ArcticEng/SmokeSense/hardware/DataGuard_Chamber_TSL_v3.stl

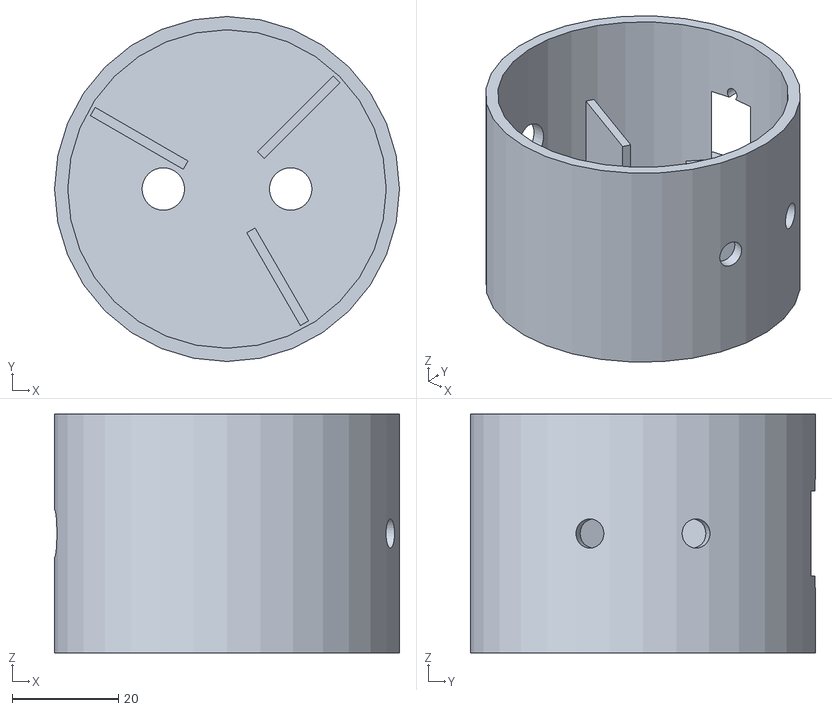
[picture p5: CAD file, 2026-06-24]
hardware/DataGuard_Chamber_TSL_v3.stl
65.0 x 65.0 x 45.0
