ArcticEng/SmokeSense/DataGuard_BringUp_Test_Protocol.docx

DataGuard DG-100

Prototype Bring-up & Test Protocol

Electromechanical commissioning procedure and evidence record

Arctic Engineering · Cape Town

Document owner: ___________________ Version: _______ Date: ____ / ____ / 2026

Records produced by this procedure form part of the R&D evidence base — date, initial and attach evidence at every stage.

# How to use this protocol

Work through the stages in order. A stage is only passed when its expected result is met; if it fails, record what happened and the corrective action, then re-test — failed attempts and iterations are themselves valuable R&D evidence, so do not discard them.

For every numbered check, fill in the Result · date · initials column and capture at least one piece of evidence: a photograph of the bench/wiring, a serial-monitor or dashboard screenshot, or the measured values. Reference each evidence file in the table (e.g. IMG_014).

## Equipment & sources

- Bench power supply: Separate, current-limited rail for the optical LED supply (VLED), isolated from the ESP32 5 V.
- Digital multimeter: Continuity, rail voltages, current draw.
- Laptop + USB: PlatformIO for flashing and serial monitor; ADI Wavetool for the optical chamber (see chamber checklist).
- Smoke sources: Smouldering source (smouldering cotton wick or incense) for large particles; a small controlled flame (tea-light) for fine particles; a reference smoke detector for comparison.
- Air handling: Small fan and a way to clear the chamber/enclosure to clean air between tests; conduct flame tests safely with extinguisher to hand.
- ESD precautions: Wrist strap / grounded mat when handling boards and sensors.

# Stage 0 — Pre-power inspection

# | Check / method | Expected result | Result · date · initials

1 | Visual inspection of all boards and the populated chamber; no solder bridges, correct component orientation (LED anodes, photodiode cathodes). | No defects; components seated in correct bores at the design angles.
2 | Continuity / short test between 3V3, 5V, VLED and GND with power OFF. | No short between any supply rail and ground.
3 | Confirm VLED is on its own rail, not bridged to the ESP32 5 V. | VLED isolated; common ground only.

# Stage 1 — Power & supply rails

# | Check / method | Expected result | Result · date · initials

1 | Apply power; measure 3V3 and 5V rails at the board. | Rails within ±5% of nominal.
2 | Measure VLED rail. | Within the LED operating range (≥ blue LED forward voltage + headroom).
3 | Observe total current draw at idle. | Sane, stable; no thermal runaway or browning-out.

# Stage 2 — MCU, firmware & communications

# | Check / method | Expected result | Result · date · initials

1 | Flash firmware (cd firmware && pio run -t upload). Open serial monitor at 115200. | Clean boot log; no panics or reset loops.
2 | Confirm Wi-Fi association. | Device obtains an IP; RSSI reported.
3 | Confirm MQTT connection to the broker. | Connected; status/heartbeat visible on the broker.

# Stage 3 — I²C bus scan

Confirm every I²C device enumerates before testing sensors individually.

# | Check / method | Expected result | Result · date · initials

1 | Run an I²C scan (serial log or scanner sketch). | ADS1115 at 0x48, BME680 at 0x77 and the ADPD4101 at 0x24 all present.
2 | Check bus stability with all three devices fitted. | Stable; no NAK storms — adjust pull-ups toward ~2.2–4.7 kΩ effective if needed.

# Stage 4 — Individual sensor verification

## 4.1 BME680 — air chemistry & climate

# | Check / method | Expected result | Result · date · initials

1 | Read temperature, humidity, pressure. | Plausible vs ambient room conditions.
2 | Observe VOC resistance trend (breathe near sensor). | Reading responds, then recovers to baseline.

## 4.2 Gas — ADS1115 + Alphasense H₂ / CO

# | Check / method | Expected result | Result · date · initials

1 | Read raw WE and AE channels (A0–A3); record clean-air baseline. | Stable differential baseline; no rail-pinning.
2 | Apply a known stimulus to the CO / H₂ cell (per cell datasheet-safe method). | Reading rises above baseline and recovers.

## 4.3 MAX31865 + PT100 — precision temperature

# | Check / method | Expected result | Result · date · initials

1 | Read RTD temperature; compare to a reference thermometer. | Within sensor tolerance of reference.
2 | Warm the probe; observe rate-of-rise. | Temperature and rate track the applied change.

## 4.4 VESDA & suppression analog inputs

# | Check / method | Expected result | Result · date · initials

1 | Sweep the VESDA input (pot or 4–20 mA simulation) on GPIO36. | ADC reading scales correctly across range.
2 | Apply / simulate suppression cylinder pressure on GPIO39. | Pressure reading scales correctly.

## 4.5 PMS5003 particles (if fitted)

# | Check / method | Expected result | Result · date · initials

1 | Enable use_pms; read particle counts on UART2. | Valid PM1.0 / PM2.5 / PM10 frames received.

# Stage 5 — Optical chamber

The optical chamber has its own detailed procedure — see Optical Chamber Bench Bring-up & Calibration Checklist. Record the headline pass/fail here once that checklist is complete.

# | Check / method | Expected result | Result · date · initials

1 | Complete the chamber bench checklist (Wavetool config, baseline, smoke response, register export, on-device boot). | Stable clean-air baseline and a clear scatter response to smoke; chamber.smoke_pct populates in telemetry.
2 | Confirm dual-wavelength discrimination (smouldering vs flaming sources). | Blue/IR and forward/back ratios shift in the expected directions between the two smoke types.

# Stage 6 — Integrated multi-sensor classification

# | Check / method | Expected result | Result · date · initials

1 | Introduce a smouldering source near the intake. | Gas + optical signals rise; classifier escalates along the ladder; fire-type hint = smouldering.
2 | Introduce a fine-particle flame source. | Rate-of-rise + fine-particle signature; fire-type hint = flaming.
3 | Introduce a confounder (steam / cooking) with no real fire. | Smoke alone may rise but the absence of gas + rate-of-rise keeps the device from escalating (false-alarm rejection).
4 | Verify the severity ladder (monitor → emergency) and on-board sounder/relay behaviour. | Outputs track the graded confidence as configured.

# Stage 7 — End-to-end cloud & control

# | Check / method | Expected result | Result · date · initials

1 | Confirm telemetry appears on the dashboard for the device. | Live values update; device shows online.
2 | Trigger an escalation; confirm event logged and alert sent. | Event row recorded; email / SMS alert received.
3 | Change a threshold from the admin UI; confirm it reaches the device. | Device applies the change and echoes confstate — no reflash required.

## Sign-off

Role | Name / signature | Date
Built / tested by
Reviewed by
Approved by

DataGuard DG-100 — Bring-up & Test Protocol · Arctic Engineering · Confidential · Page
