ArcticEng/SmokeSense/(commit log)

2026-04-22 feat: SmokeSense platform — Node, Gateway, DataGuard with full cloud stack
2026-04-28 feat: private MQTT broker, offline buffer, email/SMS alerts, fleet map
    [SmokeSense_DataGuard.ino, dataguard_config.h]
2026-05-13 fix: upgrade bridge to Node 22 for WebSocket support
    [config.h]
2026-06-19 New Smoke Chamber and classifer
    [smoke_chamber.scad]
2026-06-22 Classifier test bench + live matrix, TSL2591 chamber driver, simulator, security & telemetry fixes
    [SmokeSense_DataGuard.ino, chamber_lightsensor.h, dataguard_config.h, runtime_config.h]
2026-06-22 Split standalone test bench from device config; mobile-friendly admin
2026-06-22 Test bench: numeric steppers on sliders + live threshold hints
2026-06-23 Operator gauges driven by each device's tuned thresholds
2026-06-23 feat(firmware): flashable build, BME temp fallback, runtime gas/MQ toggles
    - Park Gateway/MQTT sketches as .bak and drop build_src_filter so PlatformIO
    compiles only the DataGuard sketch (fixes 'undefined reference to setup()/loop()')
    - Point device at the Railway Mosquitto broker and org 'demo' with dataguard creds
    - Use the TSL2591 chamber driver (chamber_lightsensor.h) in place of the ADPD4101
    - Fall back to BME680/688 temperature for rate-of-rise when the MAX31865 RTD is absent
    - Enable MQ-7/MQ-8 gas reading (USE_MQ_FALLBACK) and add a GAS_PRESENT guard so
    unconnected ADS1115 inputs can't fake H2/CO
    - Make gas_present and use_mq per-device runtime config (RuntimeConfig + admin
    Feat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
    [SmokeSense_DataGuard.ino, dataguard_config.h, runtime_config.h]
2026-06-23 fix temp history chart, chamber retry, VOC self-cal, sensors_agreeing type
    [SmokeSense_DataGuard.ino, chamber_lightsensor.h, config.h, dataguard_config.h]
2026-06-24 Working prototype: BME688 + ADS1115/MQ gas + TSL2591 chamber live to dashboard
    - chamber enabled (TSL2591 @0x29), honest begin(), 3s retry, square-window v3 STL + spec
    - gas re-enabled (ADS1115 + MQ-7/MQ-8)
    - VOC self-cal + warm-up, BME temp offset, I2C scanner
    - dashboard temp-history fix (newest rows); sensors_agreeing DB type fix
    - wifi 2.4GHz; offline buffer disabled (crash fix)
    [DataGuard_Chamber_TSL_v3.stl]
2026-06-24 Working prototype: BME688 + ADS1115/MQ gas + TSL2591 chamber live; gas+VOC self-zero, chamber v3 STL
2026-06-24 dashboard: clear offline state — grey Offline badge, readable last-seen, offline tally, detail banner; stale devices excluded from online/alarm counts
2026-06-29 dashboard: live optical scatter-vs-time chart in the chamber panel (M2 demo)
